zachariahsharma/PNP/PNP.kicad_pcb

## KiCad design PNP.kicad_pcb (2026-10-17)

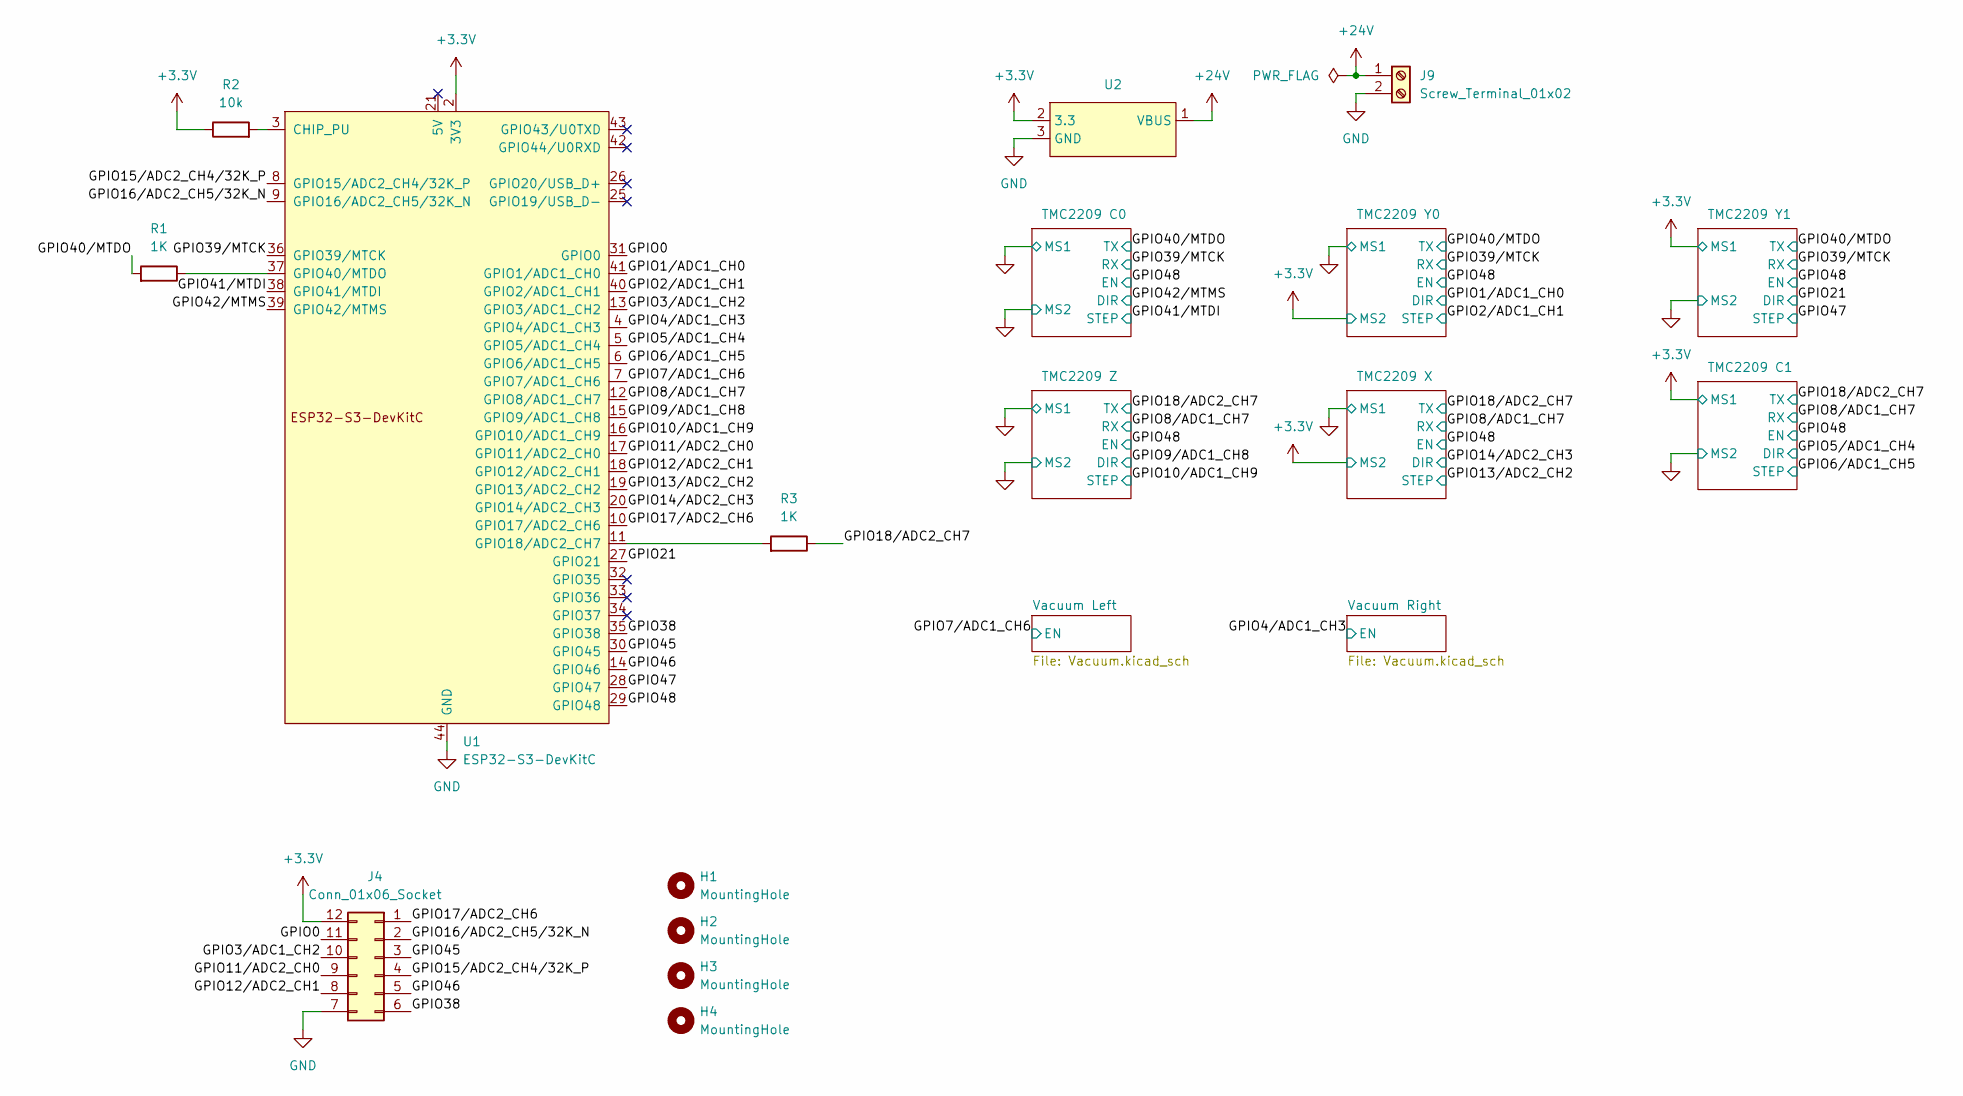
[picture p1: schematic PNP.kicad_sch]

Parts:
H1, H2, H3, H4: MountingHole; MountingHole_4.3mm_M4
J4: Conn_01x06_Socket; PinHeader_2x06_P2.54mm_Vertical
J9: Screw_Terminal_01x02; TerminalBlock_Phoenix_MKDS-1,5-2-5.08_1x02_P5.08mm_Horizont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
R1, R3: 1K; R_Axial_DIN0207_L6.3mm_D2.5mm_P7.62mm_Horizontal
R2: 10k; R_Axial_DIN0207_L6.3mm_D2.5mm_P7.62mm_Horizontal
U1: ESP32-S3-DevKitC
U2: Mini MP1584EN Buck Converter Module

Connections:
+3.3V: J4.12, R2.1, U1.1 (3V3), U1.2 (3V3), U2.2 (3.3); also elsewhere on the board
+24V: J9.1, U2.1 (VBUS); also elsewhere on the board
/GPIO0: J4.11, U1.31 (GPIO0)
/GPIO1/ADC1_CH0: U1.41 (GPIO1/ADC1_CH0); also elsewhere on the board
/GPIO2/ADC1_CH1: U1.40 (GPIO2/ADC1_CH1); also elsewhere on the board
/GPIO3/ADC1_CH2: J4.10, U1.13 (GPIO3/ADC1_CH2)
/GPIO4/ADC1_CH3: U1.4 (GPIO4/ADC1_CH3); also elsewhere on the board
/GPIO5/ADC1_CH4: U1.5 (GPIO5/ADC1_CH4); also elsewhere on the board
/GPIO6/ADC1_CH5: U1.6 (GPIO6/ADC1_CH5); also elsewhere on the board
/GPIO7/ADC1_CH6: U1.7 (GPIO7/ADC1_CH6); also elsewhere on the board
/GPIO9/ADC1_CH8: U1.15 (GPIO9/ADC1_CH8); also elsewhere on the board
/GPIO10/ADC1_CH9: U1.16 (GPIO10/ADC1_CH9); also elsewhere on the board
/GPIO11/ADC2_CH0: J4.9, U1.17 (GPIO11/ADC2_CH0)
/GPIO12/ADC2_CH1: J4.8, U1.18 (GPIO12/ADC2_CH1)
/GPIO13/ADC2_CH2: U1.19 (GPIO13/ADC2_CH2); also elsewhere on the board
/GPIO14/ADC2_CH3: U1.20 (GPIO14/ADC2_CH3); also elsewhere on the board
/GPIO15/ADC2_CH4/32K_P: J4.4, U1.8 (GPIO15/ADC2_CH4/32K_P)
/GPIO17/ADC2_CH6: J4.1, U1.10 (GPIO17/ADC2_CH6)
/GPIO18/ADC2_CH7: R3.1, U1.12 (GPIO8/ADC1_CH7); also elsewhere on the board
/GPIO21: U1.27 (GPIO21); also elsewhere on the board
/GPIO38: J4.6, U1.35 (GPIO38)
/GPIO39/MTCK: R1.2, U1.36 (GPIO39/MTCK); also elsewhere on the board
/GPIO41/MTDI: U1.38 (GPIO41/MTDI); also elsewhere on the board
/GPIO42/MTMS: U1.39 (GPIO42/MTMS); also elsewhere on the board
/GPIO45: J4.3, U1.30 (GPIO45)
/GPIO46: J4.5, U1.14 (GPIO46)
/GPIO47: U1.28 (GPIO47); also elsewhere on the board
/GPIO48: U1.29 (GPIO48); also elsewhere on the board
GND: J4.7, J9.2, U1.22 (GND), U1.23 (GND), U1.24 (GND), U1.44 (GND), U2.3 (GND); also elsewhere on the board
unnamed: R2.2, U1.3 (CHIP_PU)
unnamed: R3.2, U1.11 (GPIO18/ADC2_CH7)
unnamed: R1.1, U1.37 (GPIO40/MTDO)

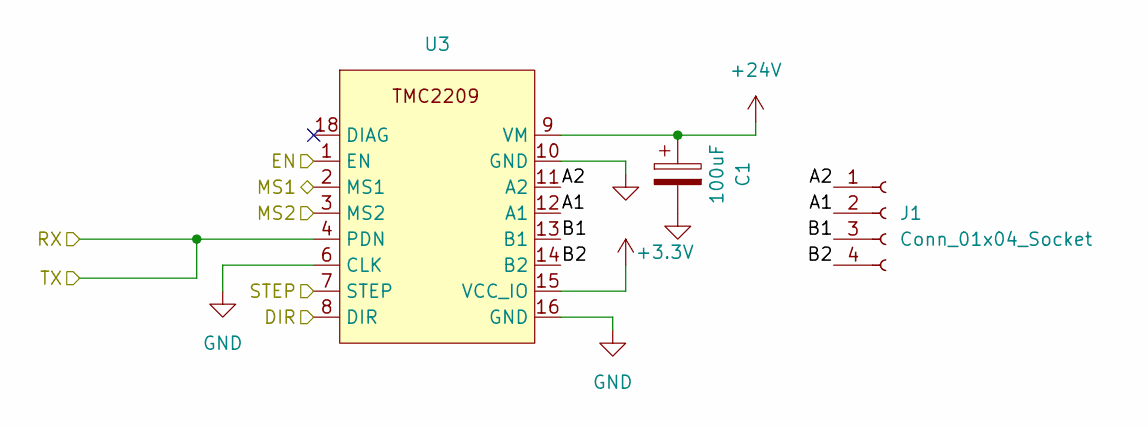
[picture p2: schematic TMC2209_Daughterboard_Circuit.kicad_sch]

Parts:
C1: 100uF; CP_Radial_D8.0mm_P3.50mm
J1: Conn_01x04_Socket; JST_EH_B4B-EH-A_1x04_P2.50mm_Vertical
U3: TMC2209 V1.3

Connections:
+3.3V: U3.3 (MS2), U3.15 (VCC_IO); also elsewhere on the board
+24V: C1.1, U3.9 (VM); also elsewhere on the board
/GPIO13/ADC2_CH2: U3.7 (STEP); also elsewhere on the board
/GPIO14/ADC2_CH3: U3.8 (DIR); also elsewhere on the board
/GPIO18/ADC2_CH7: U3.4 (PDN); also elsewhere on the board
/GPIO48: U3.1 (EN); also elsewhere on the board
/TMC2209 X/A1: J1.2, U3.12 (A1)
/TMC2209 X/A2: J1.1, U3.11 (A2)
/TMC2209 X/B1: J1.3, U3.13 (B1)
/TMC2209 X/B2: J1.4, U3.14 (B2)
GND: C1.2, U3.2 (MS1), U3.6 (CLK), U3.10 (GND), U3.16 (GND); also elsewhere on the board

Parts of its further copies:
C2, C3, C4, C5, C6: 100uF; CP_Radial_D8.0mm_P3.50mm
J2, J3, J5, J6, J7: Conn_01x04_Socket; JST_EH_B4B-EH-A_1x04_P2.50mm_Vertical

Connections of its further copies:
+24V: C2.1, C3.1, C4.1, C5.1, C6.1; also elsewhere on the board
/TMC2209 C0/A1: J6.2; also elsewhere on the board
/TMC2209 C0/A2: J6.1; also elsewhere on the board
/TMC2209 C0/B1: J6.3; also elsewhere on the board
/TMC2209 C0/B2: J6.4; also elsewhere on the board
/TMC2209 C1/A1: J7.2; also elsewhere on the board
/TMC2209 C1/A2: J7.1; also elsewhere on the board
/TMC2209 C1/B1: J7.3; also elsewhere on the board
/TMC2209 C1/B2: J7.4; also elsewhere on the board
/TMC2209 Y0/A1: J2.2; also elsewhere on the board
/TMC2209 Y0/A2: J2.1; also elsewhere on the board
/TMC2209 Y0/B1: J2.3; also elsewhere on the board
/TMC2209 Y0/B2: J2.4; also elsewhere on the board
/TMC2209 Y1/A1: J3.2; also elsewhere on the board
/TMC2209 Y1/A2: J3.1; also elsewhere on the board
/TMC2209 Y1/B1: J3.3; also elsewhere on the board
/TMC2209 Y1/B2: J3.4; also elsewhere on the board
/TMC2209 Z/A1: J5.2; also elsewhere on the board
/TMC2209 Z/A2: J5.1; also elsewhere on the board
/TMC2209 Z/B1: J5.3; also elsewhere on the board
/TMC2209 Z/B2: J5.4; also elsewhere on the board
GND: C2.2, C3.2, C4.2, C5.2, C6.2; also elsewhere on the board

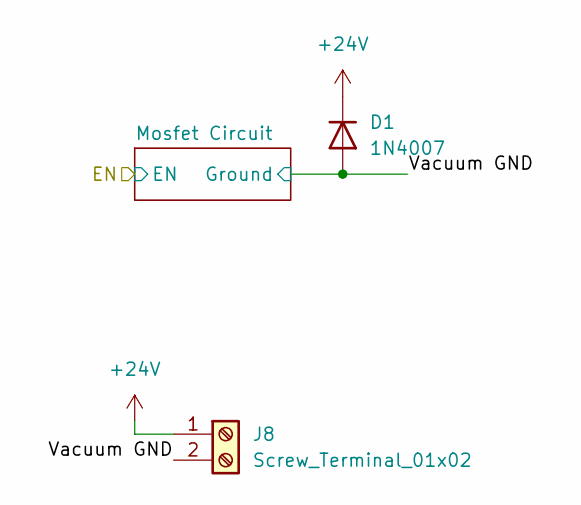
[picture p3: schematic Vacuum.kicad_sch]

Parts:
D1: 1N4007; D_DO-41_SOD81_P10.16mm_Horizontal
J8: Screw_Terminal_01x02; TerminalBlock_Phoenix_MKDS-1,5-2-5.08_1x02_P5.08mm_Horizont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

Connections:
+24V: D1.1 (K), J8.1; also elsewhere on the board
/Vacuum Left/Vacuum GND: D1.2 (A), J8.2; also elsewhere on the board

Parts of its further copies:
D2: 1N4007; D_DO-41_SOD81_P10.16mm_Horizontal
J10: Screw_Terminal_01x02; TerminalBlock_Phoenix_MKDS-1,5-2-5.08_1x02_P5.08mm_Horizont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

Connections of its further copies:
+24V: D2.1 (K), J10.1; also elsewhere on the board
/Vacuum Right/Vacuum GND: D2.2 (A), J10.2; also elsewhere on the board

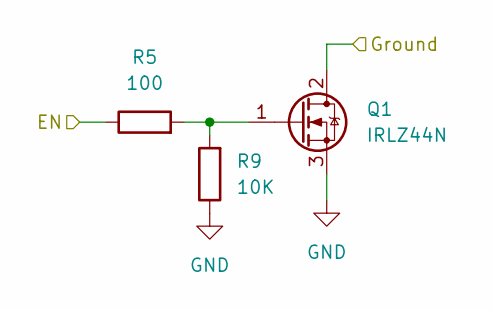
[picture p4: schematic 3.3V_Circuit.kicad_sch]

Parts:
Q1: IRLZ44N; TO-220-3_Vertical
R5: 100; R_Axial_DIN0207_L6.3mm_D2.5mm_P7.62mm_Horizontal
R9: 10K; R_Axial_DIN0207_L6.3mm_D2.5mm_P7.62mm_Horizontal

Connections:
/GPIO7/ADC1_CH6: R5.1; also elsewhere on the board
/Vacuum Left/Vacuum GND: Q1.2 (D); also elsewhere on the board
GND: Q1.3 (S), R9.1; also elsewhere on the board
unnamed: Q1.1 (G), R5.2, R9.2

Parts of its further copies:
Q3: IRLZ44N; TO-220-3_Vertical
R12: 100; R_Axial_DIN0207_L6.3mm_D2.5mm_P7.62mm_Horizontal
R13: 10K; R_Axial_DIN0207_L6.3mm_D2.5mm_P7.62mm_Horizontal

Connections of its further copies:
/GPIO4/ADC1_CH3: R12.1; also elsewhere on the board
/Vacuum Right/Vacuum GND: Q3.2 (D); also elsewhere on the board
GND: Q3.3 (S), R13.1; also elsewhere on the board
unnamed: Q3.1 (G), R12.2, R13.2

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
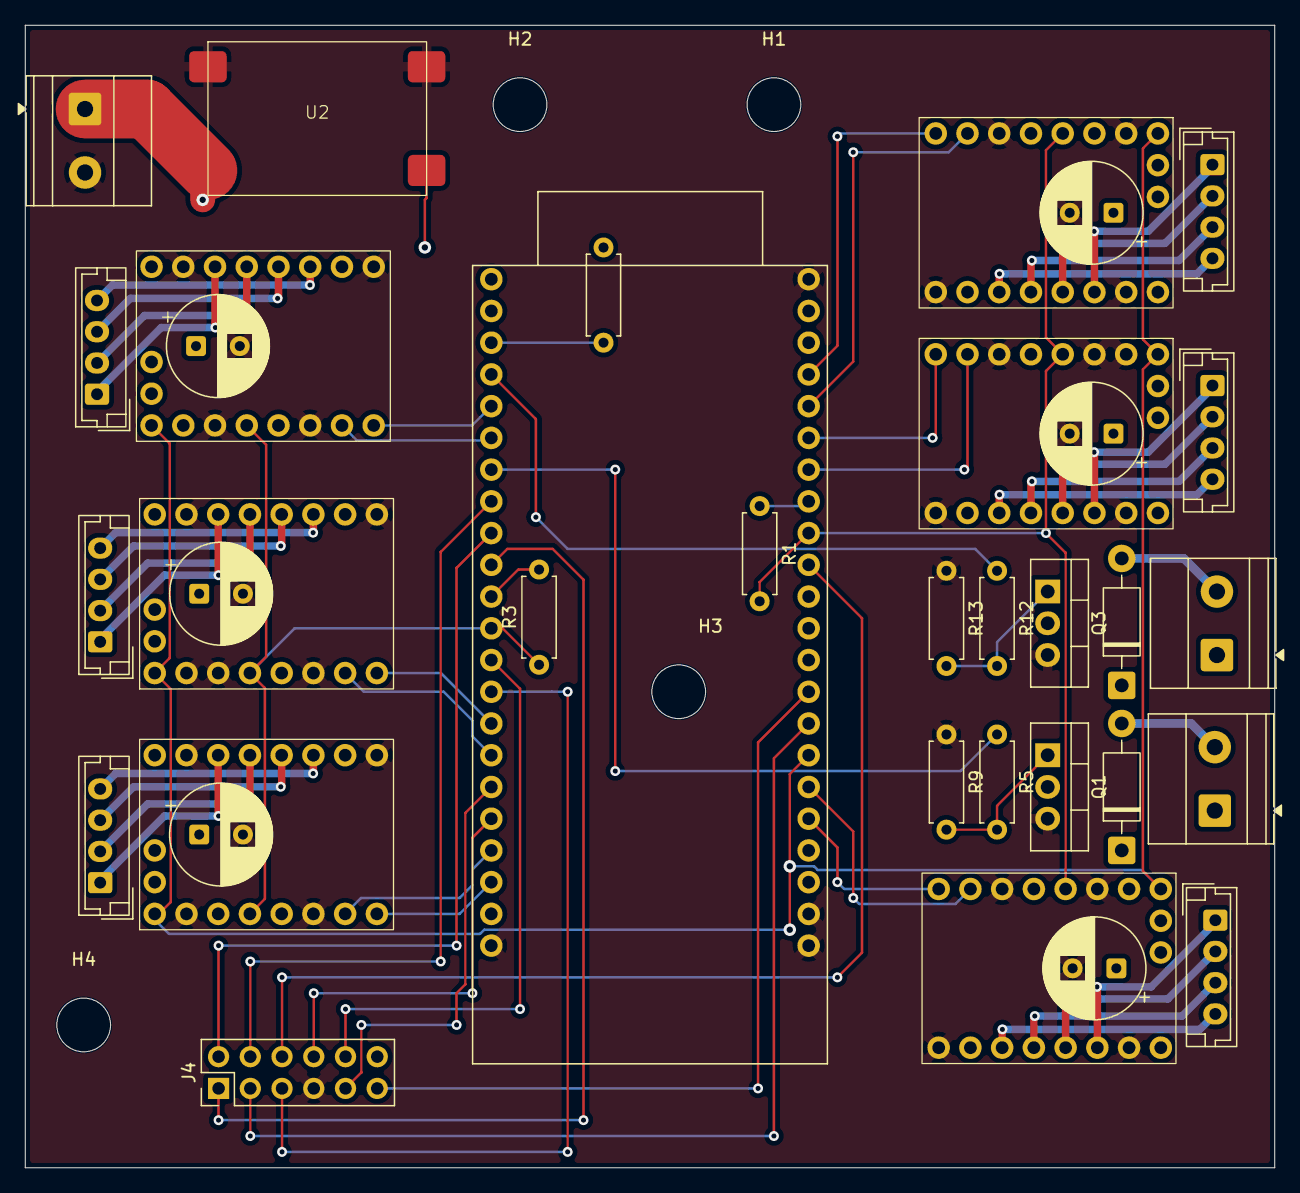
[picture p5: board PNP.kicad_pcb from above]

Board: 4 copper layers, 100.0 x 91.4 mm, 39 parts (0 on the bottom side), 61 nets.

Other parts of the board:
U4, U5, U7, U8, U9: TMC2209 V1.3

Their connections:
+3.3V: U4.3 (MS2), U4.15 (VCC_IO), U5.2 (MS1), U5.15 (VCC_IO), U7.15 (VCC_IO), U8.15 (VCC_IO), U9.2 (MS1), U9.15 (VCC_IO); also elsewhere on the board
+24V: U4.9 (VM), U5.9 (VM), U7.9 (VM), U8.9 (VM), U9.9 (VM); also elsewhere on the board
/GPIO1/ADC1_CH0: U4.8 (DIR); also elsewhere on the board
/GPIO2/ADC1_CH1: U4.7 (STEP); also elsewhere on the board
/GPIO5/ADC1_CH4: U9.8 (DIR); also elsewhere on the board
/GPIO6/ADC1_CH5: U9.7 (STEP); also elsewhere on the board
/GPIO9/ADC1_CH8: U7.8 (DIR); also elsewhere on the board
/GPIO10/ADC1_CH9: U7.7 (STEP); also elsewhere on the board
/GPIO18/ADC2_CH7: U7.4 (PDN), U9.4 (PDN); also elsewhere on the board
/GPIO21: U5.8 (DIR); also elsewhere on the board
/GPIO39/MTCK: U4.4 (PDN), U5.4 (PDN), U8.4 (PDN); also elsewhere on the board
/GPIO41/MTDI: U8.7 (STEP); also elsewhere on the board
/GPIO42/MTMS: U8.8 (DIR); also elsewhere on the board
/GPIO47: U5.7 (STEP); also elsewhere on the board
/GPIO48: U4.1 (EN), U5.1 (EN), U7.1 (EN), U8.1 (EN), U9.1 (EN); also elsewhere on the board
/TMC2209 C0/A1: U8.12 (A1); also elsewhere on the board
/TMC2209 C0/A2: U8.11 (A2); also elsewhere on the board
/TMC2209 C0/B1: U8.13 (B1); also elsewhere on the board
/TMC2209 C0/B2: U8.14 (B2); also elsewhere on the board
/TMC2209 C1/A1: U9.12 (A1); also elsewhere on the board
/TMC2209 C1/A2: U9.11 (A2); also elsewhere on the board
/TMC2209 C1/B1: U9.13 (B1); also elsewhere on the board
/TMC2209 C1/B2: U9.14 (B2); also elsewhere on the board
/TMC2209 Y0/A1: U4.12 (A1); also elsewhere on the board
/TMC2209 Y0/A2: U4.11 (A2); also elsewhere on the board
/TMC2209 Y0/B1: U4.13 (B1); also elsewhere on the board
/TMC2209 Y0/B2: U4.14 (B2); also elsewhere on the board
/TMC2209 Y1/A1: U5.12 (A1); also elsewhere on the board
/TMC2209 Y1/A2: U5.11 (A2); also elsewhere on the board
/TMC2209 Y1/B1: U5.13 (B1); also elsewhere on the board
/TMC2209 Y1/B2: U5.14 (B2); also elsewhere on the board
/TMC2209 Z/A1: U7.12 (A1); also elsewhere on the board
/TMC2209 Z/A2: U7.11 (A2); also elsewhere on the board
/TMC2209 Z/B1: U7.13 (B1); also elsewhere on the board
/TMC2209 Z/B2: U7.14 (B2); also elsewhere on the board
GND: U4.2 (MS1), U4.6 (CLK), U4.10 (GND), U4.16 (GND), U5.3 (MS2), U5.6 (CLK), U5.10 (GND), U5.16 (GND), U7.2 (MS1), U7.3 (MS2), U7.6 (CLK), U7.10 (GND), U7.16 (GND), U8.2 (MS1), U8.3 (MS2), U8.6 (CLK), U8.10 (GND), U8.16 (GND), U9.3 (MS2), U9.6 (CLK), U9.10 (GND), U9.16 (GND); also elsewhere on the board
