zachariahsharma/PNP/code/include/wifi_secrets.example.h

// Copy this file to wifi_secrets.h and fill in your network.
// wifi_secrets.h is gitignored so your password never gets committed.
#pragma once

#define WIFI_SSID "your-network-name"
#define WIFI_PASS "your-network-password"

// Password required to push OTA (over-the-air) firmware updates. Change it.
#define OTA_PASS  "pnp-ota"
