zachariahsharma/PNP/(commit log)

2026-10-09 Add .gitignore; stop tracking KiCad backups, .pio build output, .prl and .DS_Store
    Files remain on disk; removed from the index only.
2026-10-09 Swap J4 to 2x06 header, drop KY-023 joysticks, rework TMC2209 daughterboard layout; add V0.2.0/V0.2.1 fab outputs
    - PNP: J4 Conn_01x06 -> Conn_02x06 (PinHeader_2x06), removed Left/Right Joystick (U6/U10) from schematic and PCB, PCB re-routed (370 -> 366 segments area, vias 70 -> 58, zones 2 -> 1), ESP32-S3-DevKitC and MP1584EN footprints moved to Footprints lib, mask-to-copper clearance 0.005 mm
    - TMC2209 daughterboard: PCB re-annotated/re-laid out (C5->C2, J6->J2, U8->U4, R7 removed)
    - production/: PNP_V0.2.0 and V0.2.1 JLCPCB zips, BOM/CPL, netlist.ipc; fabrication-toolkit options
    - code/: PlatformIO .gitignore and VS Code extension recommendations
    [PNP.kicad_pcb, PNP.kicad_sch, PNP_V0.2.0_bom.csv, PNP_V0.2.0_designators.csv, PNP_V0.2.0_positions.csv, PNP_V0.2.1_bom.csv, PNP_V0.2.1_designators.csv, PNP_V0.2.1_positions.csv]
2026-10-11 Replace C1 spin test with 5-axis TMC2209 WiFi tuning panel
    main.cpp: drive C1/Z/X (UART bus A, GPIO8) and Y0/Y1 (bus B, GPIO39) over TMC2209 UART with FastAccelStepper step generation; WiFi AP 'PNP-Control' web UI for per-axis current/speed/accel/microsteps/stealthChop-spreadCycle, run-N-turns and stop, NVS-persisted slider ranges, and vacuum left/right MOSFET switches (GPIO7/GPIO4). platformio.ini: add TMCStepper and FastAccelStepper lib_deps.
    [main.cpp]
2026-10-12 Add C0 axis and Y0/Y1 linked motion to tuning panel; live speed/dir changes only affect spinning motors
    New C0 driver on UART bus B (addr 0, STEP 41 / DIR 42). 'Link Y0 <-> Y1' toggle (/pair, persisted in NVS) so both Y motors spin/move together. Track per-axis spinning state so slider/direction tweaks re-apply only to motors already running continuously instead of starting them.
2026-10-17 Update PNP PCB routing and STEP export path
    Re-route tracks/vias across GPIO, Vacuum GND, TMC2209 axis, and +3.3V nets; adjust some via sizes; set project STEP export to Downloads/PNP.step.
    [PNP.kicad_pcb]
2026-10-21 Add Xbox gamepad jog/macro control, STOP ALL button, and per-motor current caps to PNP driver tuner
    - Per-axis RMS current limits from motor ratings (Nema 8 0.6A, Nema 17 2.1A)
    - New /jog, /goto, /zero endpoints; report step position in /state
    - Linked Y0/Y1 sibling mirrors speed/accel/dir/microsteps on run
    - Stop uses forceStop (no decel); run-turns defaults to 400 Hz if speed unset
    - UI: STOP ALL, motor labels, online/no-UART status, gamepad panel
    - Add code/ui-preview.html mock page for previewing the tuner UI
2026-10-22 Join home WiFi with AP fallback and add password-protected ArduinoOTA updates to PNP firmware
    - Connect as STA using WIFI_SSID/WIFI_PASS from include/wifi_secrets.h, fall back to PNP-Control AP after 12 s
    - ArduinoOTA (hostname pnp) stops all axes, disables drivers and vacuum before reflashing
    - Add wifi_secrets.example.h template; gitignore real wifi_secrets.h and ui-preview.html
2026-10-24 Fix TMC2209 UART TX pins and RMT turn-stop bug; add WebSocket Xbox controller and X-button 1/16 precision mode
    - Assign separate UART TX pins (GPIO18 on bus A, GPIO40 on bus B) so all 6 TMC2209 drivers connect over UART
    - Pin FastAccelStepper 0.31.7 (33b1f96e) to fix non-terminating RMT moves on Y1/C0; flush pulse queues on stop, map 1 microstep to 0, and add /motiontest diagnostic
    - Replace per-axis HTTP gamepad polling with a 25 Hz WebSocket controller session on port 81 (/controller, /control) with 600 ms watchdog and redesigned controller-first UI
    - Boot in full-step mode (1 step/pulse) and switch all 6 axes to 1/16 microstepping at standstill while holding X (pnp-precision-1)
    - Update c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
    [main.cpp]
2026-10-26 Add Z top-zero travel limits, paired C0/C1 controller motion, and corrected vacuum/jog defaults
    [main.cpp]
